Wireb/firepick-delta/electronics/EAT0011/Hardware/README.md

### EAT0011 hot end and extruder module with I2C A2D

This hardware folder contains all the KiCad design files (logical and physical design) for the PCB. 

The gerber subdirectory has the final output files ready to be sent to a board house in standard gerber format. 

Also included in this directory is a PDF of the logics and 2 images of the front and back of the board in PNG format. 

Change list:

1. Updates for new micro.
1. Fixed silk screen for screw terminals.

TODO add info on on card programming.
