Wireb/firepick-delta/electronics/EAT0010/Hardware/EAT0010_board_bot.png

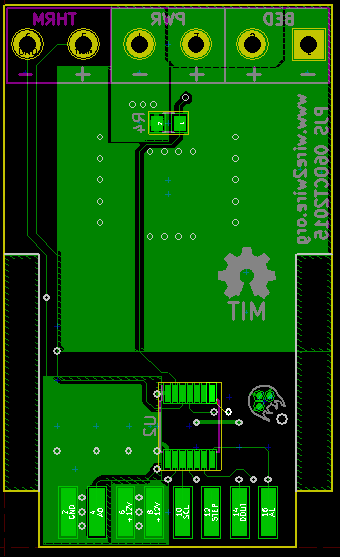
electronics/EAT0010/Hardware/EAT0010_board_bot.png
