Wireb/firepick-delta/electronics/EAT0010/Reworks/EAT0002_to_EAT0010_reworks.png

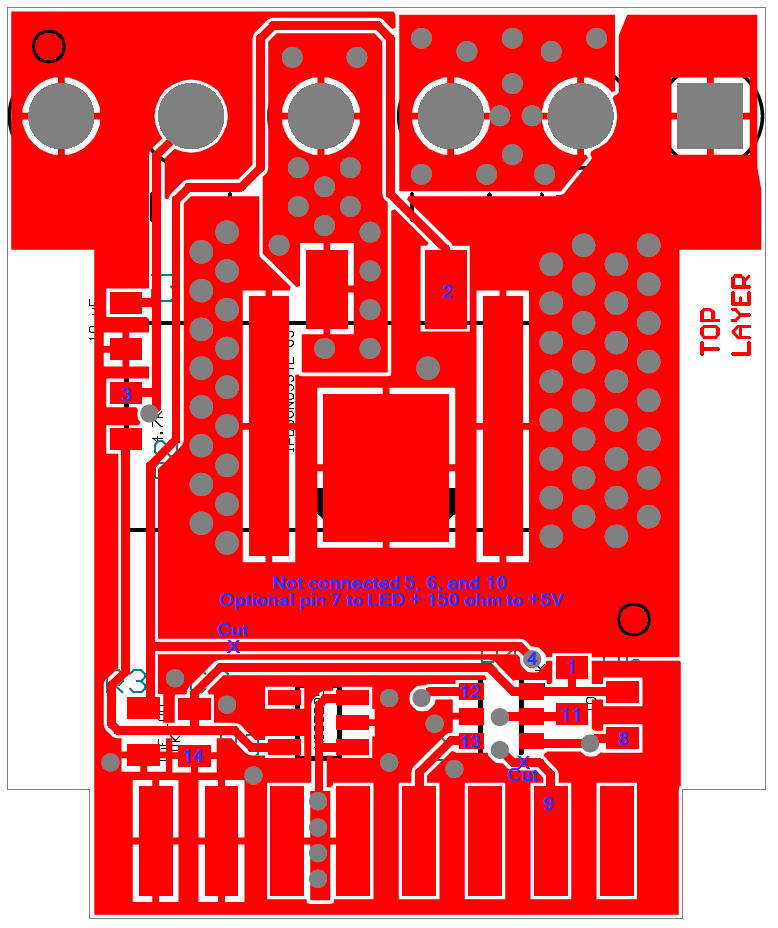
electronics/EAT0010/Reworks/EAT0002_to_EAT0010_reworks.png
