Wireb/firepick-delta/electronics/EAT0011/Hardware/EAT0011_hotend_top.png

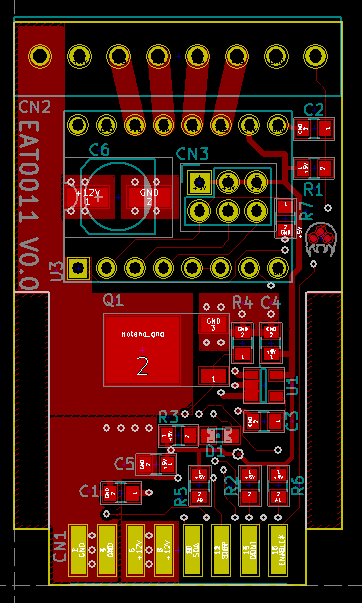
electronics/EAT0011/Hardware/EAT0011_hotend_top.png
