Wireb/firepick-delta/electronics/EAT0011/Reworks/EAT0004_to_EAT0011_top_rework.png

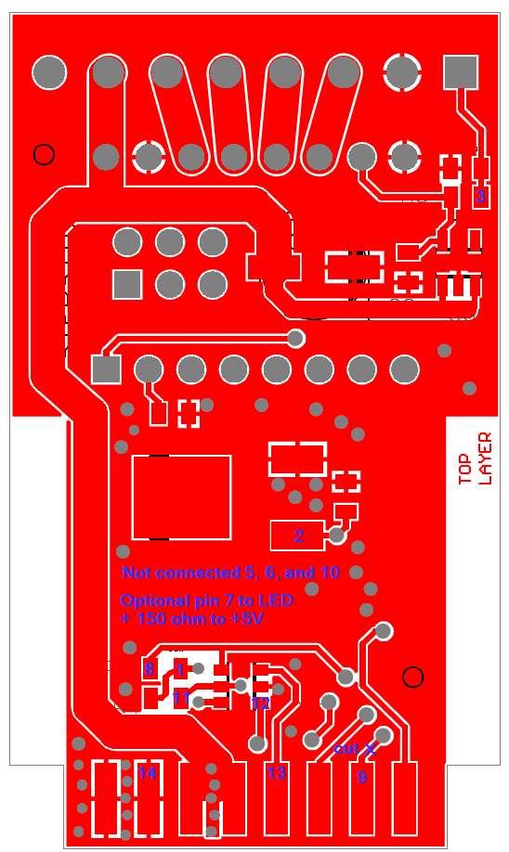
electronics/EAT0011/Reworks/EAT0004_to_EAT0011_top_rework.png
