Wireb/firepick-delta/electronics/EAT0010/Hardware/BOM.xls

 |  |  |  |  | $9.87
Q | part number | footprint | ref_des | price Q 1 | extended | link
1 | 0.1uF | Capacitors_SMD:C_0805 | C5 | $0.10 | $0.10 | http://www.digikey.com/product-detail/en/CL21F104ZBCNNNC/1276-1007-1-ND/3889093
3 | 10k | Capacitors_SMD:C_0805 | R4 R6 R5 | $0.10 | $0.30 | http://www.digikey.com/product-detail/en/RC0805FR-0710KL/311-10.0KCRCT-ND/730482
2 | 10uF | Capacitors_SMD:C_0805 | C2 C1 | $0.20 | $0.40 | http://www.digikey.com/product-detail/en/GRM21BR61E106KA73L/490-5523-1-ND/2334919
1 | 1k | Capacitors_SMD:C_0805 | R3 | $0.10 | $0.10 | http://www.digikey.com/product-detail/en/RC0805FR-071KL/311-1.00KCRCT-ND/730391
1 | 1uF 10V | Capacitors_SMD:C_0805 | C4 | $0.10 | $0.10 | http://www.digikey.com/product-detail/en/CC0805ZRY5V7BB105/311-1457-1-ND/2833763
1 | 4.7k 1% | Capacitors_SMD:C_0805 | R1 | $0.10 | $0.10 | http://www.digikey.com/product-detail/en/RC0805FR-074K7L/311-4.70KCRCT-ND/730876
1 | CONN_02X08 | PJS_smt_std:16pin_straddle_mount_100mil | CN1 | $0.53 | $0.53 | http://www.digikey.com/product-detail/en/PRPC008DAAN-RC/S2011EC-08-ND/2775286
1 | IPD30N03S4L-09 | TO252-3 | Q1 | $0.65 | $0.65 | http://www.digikey.com/product-detail/en/IPD30N03S4L-09/IPD30N03S4L-09INCT-ND/2269936
1 | MIC5205-5.0MB5 | Housings_SOT-23_SOT-143_TSOT-6:SOT-23-5 | U1 | $0.62 | $0.62 | http://www.digikey.com/product-detail/en/MIC5205-5.0YM5%20TR/576-1261-1-ND/771888
1 | OSTTA060161 | On_shore:OSTTA060161 | CN2 | $1.16 | $1.16 | http://www.digikey.com/product-detail/en/OSTTA060161/ED2566-ND/614515
1 | PIC16F1704 | Housings_SSOP:TSSOP-14_4.4x5mm_Pitch0.65mm | U2 | $1.18 | $1.18 | http://www.digikey.com/product-search/en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
1 | Red | LEDs:LED-0805 | D1 | $0.26 | $0.26 | http://www.digikey.com/product-detail/en/LH%20R974-LP-1/475-1415-1-ND/1802604
1 | V-1100-SMD/B | PJS_smt_std:V-1100-SMD | HS1 | $0.70 | $0.70 | http://www.digikey.com/product-detail/en/V-1100-SMD%2FB-L/AE10775-ND/3511509
1 | PCB |  |  | $3.67 | $3.67 | https://www.oshpark.com/shared_projects/yRDqqqbZ
