Wireb/firepick-delta/electronics/EAT0011/Hardware/BOM.xls

 |  |  |  |  | $15.16
Q | part number | footprint | ref_des | price Q 1 | extended | link
1 | 0.1uF | Capacitors_SMD:C_0805 | C5 | $0.10 | $0.10 | http://www.digikey.com/product-detail/en/CL21F104ZBCNNNC/1276-1007-1-ND/3889093
1 | 100k | Capacitors_SMD:C_0805 | R7 | $0.10 | $0.00 | http://www.digikey.com/product-detail/en/RC0805FR-07100KL/311-100KCRCT-ND/730491
1 | 100uF 25V | Capacitors_SMD:c_elec_6.3x7.7 | C6 | $0.37 | $0.00 | http://www.digikey.com/product-detail/en/UWT1E101MCL1GS/493-2190-1-ND/590165
3 | 10k | Capacitors_SMD:C_0805 | R4 R6 R5 | $0.10 | $0.30 | http://www.digikey.com/product-detail/en/RC0805FR-0710KL/311-10.0KCRCT-ND/730482
2 | 10uF | Capacitors_SMD:C_0805 | C2 C1 | $0.20 | $0.40 | http://www.digikey.com/product-detail/en/GRM21BR61E106KA73L/490-5523-1-ND/2334919
1 | 1k | Capacitors_SMD:C_0805 | R3 | $0.10 | $0.10 | http://www.digikey.com/product-detail/en/RC0805FR-071KL/311-1.00KCRCT-ND/730391
1 | 1uF 10V | Capacitors_SMD:C_0805 | C4 | $0.10 | $0.10 | http://www.digikey.com/product-detail/en/CC0805ZRY5V7BB105/311-1457-1-ND/2833763
1 | 4.7k 1% | Capacitors_SMD:C_0805 | R1 | $0.10 | $0.10 | http://www.digikey.com/product-detail/en/RC0805FR-074K7L/311-4.70KCRCT-ND/730876
1 | CONN_02X03 | Socket_Strips:Socket_Strip_Straight_2x03 | CN3 | $0.31 | $0.00 | http://www.digikey.com/product-detail/en/67997-206HLF/609-3234-ND/1878491
1 | CONN_02X08 | PJS_smt_std:16pin_straddle_mount_100mil | CN1 | $0.53 | $0.53 | http://www.digikey.com/product-detail/en/PRPC008DAAN-RC/S2011EC-08-ND/2775286
1 | FQD13N06LTM | PJS_smt_std:D-Pak_TO252AA | Q1 | $0.68 | $0.00 | http://www.digikey.com/product-search/en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
1 | JST OSTTE080104 | On_shore:OSTTE080104 | CN2 | $1.21 | $0.00 | http://www.digikey.com/product-search/en?vendor=0&keywords=OSTTE080104
1 | MIC5205-5.0MB5 | Housings_SOT-23_SOT-143_TSOT-6:SOT-23-5 | U1 | $0.62 | $0.62 | http://www.digikey.com/product-detail/en/MIC5205-5.0YM5%20TR/576-1261-1-ND/771888
1 | PIC16F1704 | Housings_SSOP:TSSOP-14_4.4x5mm_Pitch0.65mm | U2 | $1.18 | $1.18 | http://www.digikey.com/product-search/en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
1 | Red | LEDs:LED-0805 | D1 | $0.26 | $0.26 | http://www.digikey.com/product-detail/en/LH%20R974-LP-1/475-1415-1-ND/1802604
1 | Stepstick | Stepstick:Stepstick | U3 | $5.95 | $5.95 | https://www.pololu.com/product/1182
2 | sockets for above | pth 1x8 0.1" pitch |  | $0.86 | $1.72 | http://www.digikey.com/product-detail/en/PPTC081LFBN-RC/S7006-ND/810147
1 | PCB |  |  | $3.80 | $3.80 | https://www.oshpark.com/shared_projects/VwKjZDkB
