Wireb/firepick-delta/electronics/EAT0010/Hardware/partnumber.csv

Q | part number | footprint | ref_des
1 | 0.1uF | Capacitors_SMD:C_0805 | C5
3 | 10k | Capacitors_SMD:C_0805 | R4 R6 R5
2 | 10uF | Capacitors_SMD:C_0805 | C2 C1
1 | 1k | Capacitors_SMD:C_0805 | R3
1 | 1uF 10V | Capacitors_SMD:C_0805 | C4
1 | 4.7k 1% | Capacitors_SMD:C_0805 | R1
1 | CONN_02X08 | PJS_smt_std:16pin_straddle_mount_100mil | CN1
1 | IPD30N03S4L-09 | TO252-3 | Q1
1 | MIC5205-5.0MB5 | Housings_SOT-23_SOT-143_TSOT-6:SOT-23-5 | U1
1 | Metroid | PJS-icons:metroid | icon1
1 | OSTTA060161 | On_shore:OSTTA060161 | CN2
1 | PIC16F1704 | Housings_SSOP:TSSOP-14_4.4x5mm_Pitch0.65mm | U2
1 | Red | LEDs:LED-0805 | D1
1 | V-1100-SMD/B | PJS_smt_std:V-1100-SMD | HS1
0 | no_pop | Capacitors_SMD:C_0805 | C3 R2
