Wireb/firepick-delta/electronics/EAT0011/Hardware/FPD_bed_EAT0011.pdf

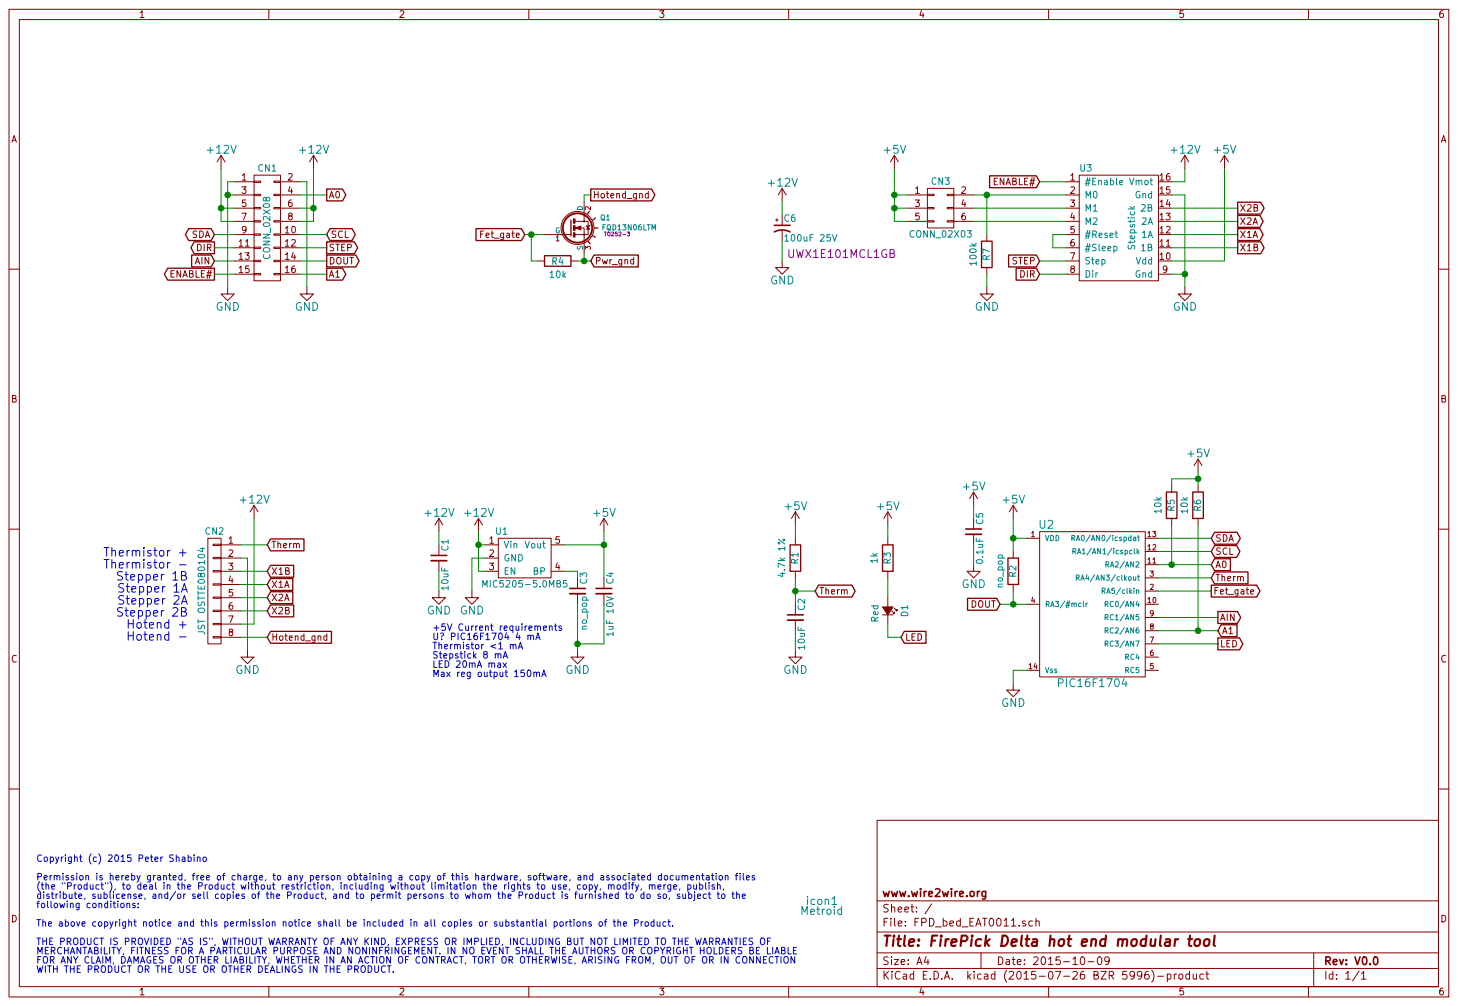
[picture p8: page 1]

2 | X1B Thermistor +

+5V Current requirements U? PIC16F1704 4 mA
Thermistor <1 mA
Stepstick 8 mA
LED 20mA max Max reg output 150mA

Copyright (c) 2015 Peter Shabino
Permission is hereby granted, free of charge, to any person obtaining a copy of this hardware, software, and associated documentation files
(the "Product"), to deal in the Product without restriction, including without limitation the rights to use, copy, modify, merge, publish,
distribute, sublicense, and/or sell copies of the Product, and to permit persons to whom the Product is furnished to do so, subject to the
following conditions:
The above copyright notice and this permission notice shall be included in all copies or substantial portions of the Product. THE PRODUCT IS PROVIDED "AS IS", WITHOUT WARRANTY OF ANY KIND, EXPRESS OR IMPLIED, INCLUDING BUT NOT LIMITED TO THE WARRANTIES OF MERCHANTABILITY, FITNESS FOR A PARTICULAR PURPOSE AND NONINFRINGEMENT. IN NO EVENT SHALL THE AUTHORS OR COPYRIGHT HOLDERS BE LIABLE FOR ANY CLAIM, DAMAGES OR OTHER LIABILITY, WHETHER IN AN ACTION OF CONTRACT, TORT OR OTHERWISE, ARISING FROM, OUT OF OR IN CONNECTION WITH THE PRODUCT OR THE USE OR OTHER DEALINGS IN THE PRODUCT.

File: FPD_bed_EAT0011.sch Sheet: / www.wire2wire.org

Id: 1/1 Title: FirePick Delta hot end modular tool
