Wireb/firepick-delta/electronics/EAT0011/Hardware/FPD_bed_EAT0011.kicad_pcb

## KiCad design electronics/EAT0011/Hardware/FPD_bed_EAT0011.kicad_pcb (2015-10-26)

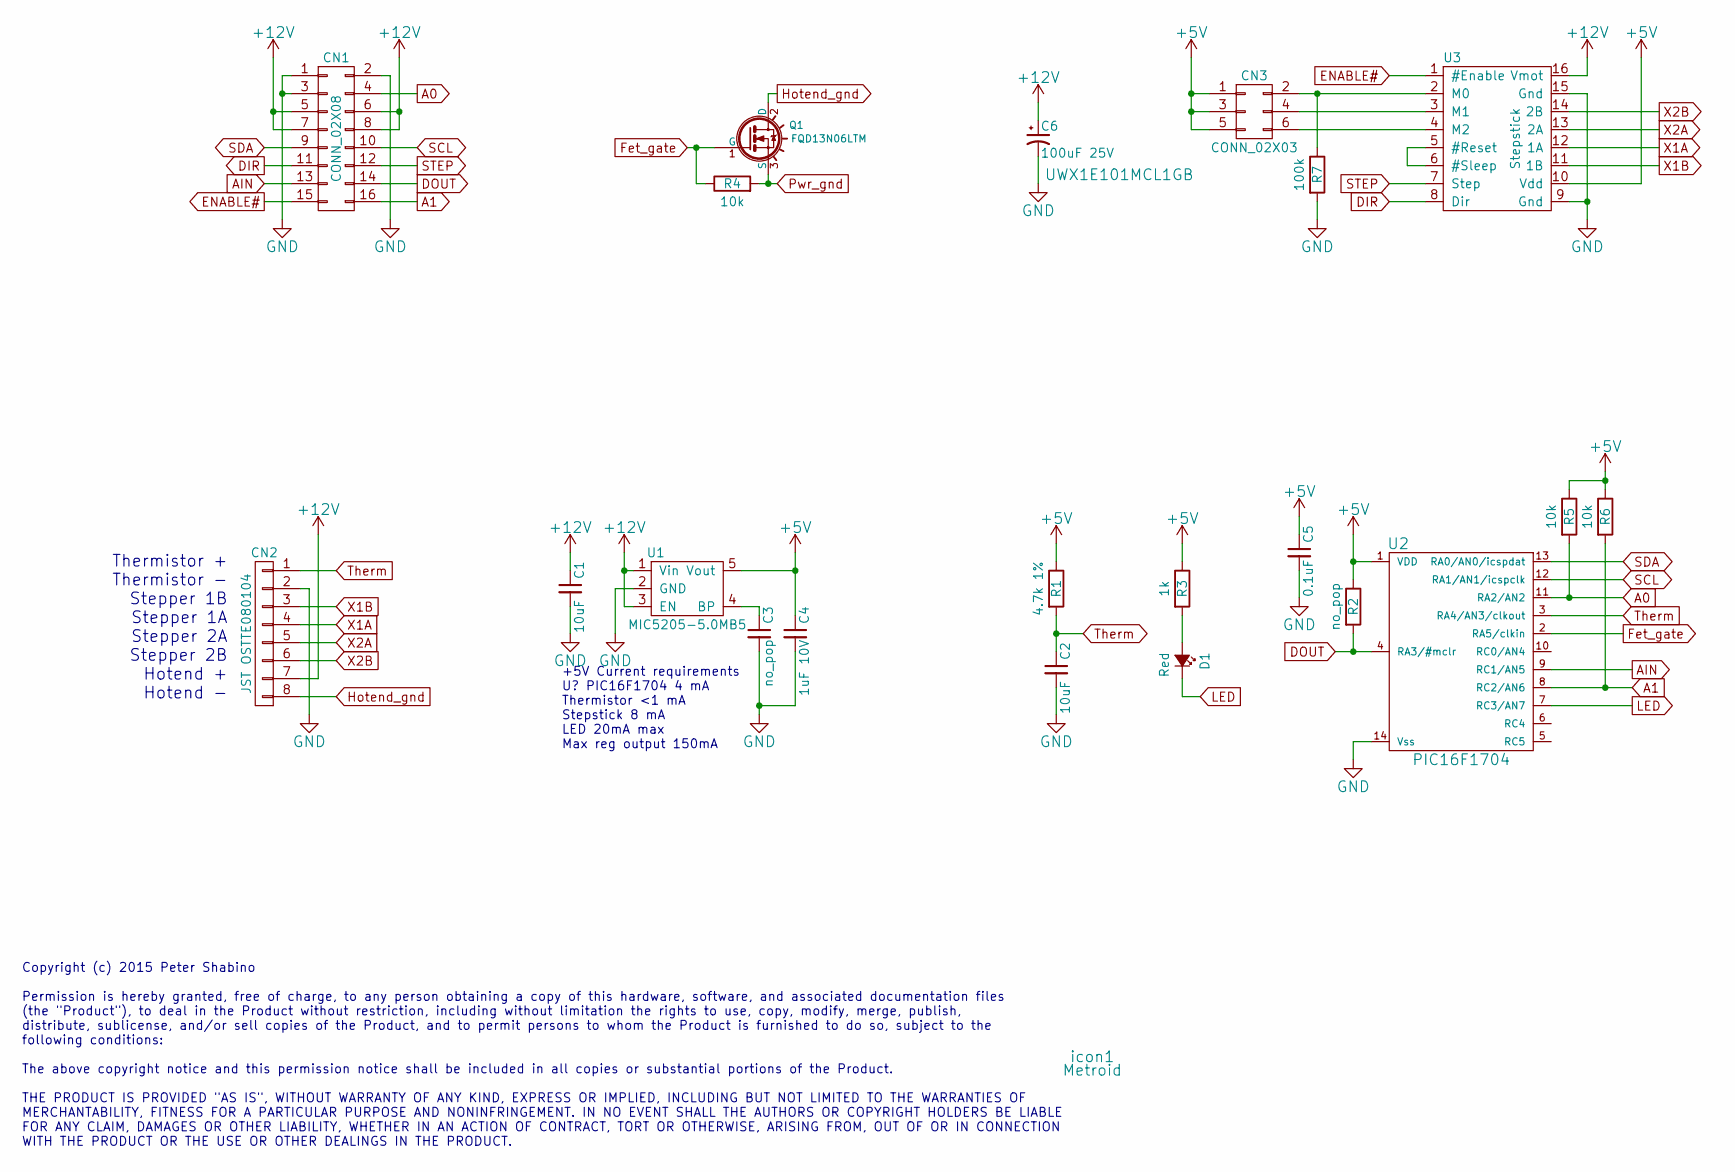
[picture p9: schematic FPD_bed_EAT0011.sch, FirePick Delta hot end modular tool]

Parts:
C1, C2: 10uF; C_0805
C3: no_pop; C_0805
C4: 1uF 10V; C_0805
C5: 0.1uF; C_0805
C6: 100uF 25V; c_elec_6.3x7.7
CN1: CONN_02X08; 16pin_straddle_mount_100mil
CN2: JST OSTTE080104; OSTTE080104
CN3: CONN_02X03; Socket_Strip_Straight_2x03
D1: Red; LED-0805
Q1: FQD13N06LTM; D-Pak_TO252AA
R1: 4.7k 1%; C_0805
R2: no_pop; C_0805
R3: 1k; C_0805
R4, R5, R6: 10k; C_0805
R7: 100k; C_0805
U1: MIC5205-5.0MB5; SOT-23-5
U2: PIC16F1704; TSSOP-14_4.4x5mm_Pitch0.65mm
U3: Stepstick
icon1: Metroid; metroid

Connections:
+5V: C4.1, C5.1, CN3.1, CN3.3, CN3.5, R1.1, R2.1, R3.1, R5.1, R6.1, U1.5 (Vout), U2.1 (VDD), U3.10 (Vdd)
+12V: C1.1, C6.1, CN1.5, CN1.6, CN1.7, CN1.8, CN2.7, U1.1 (Vin), U1.3 (EN), U3.16 (Vmot)
A0: CN1.4, R5.2, U2.11 (RA2/AN2)
A1: CN1.16, R6.2, U2.8 (RC2/AN6)
AIN: CN1.13, U2.9 (RC1/AN5)
DIR: CN1.11, U3.8 (Dir)
DOUT: CN1.14, R2.2, U2.4 (RA3/#mclr)
ENABLE#: CN1.15, U3.1 (#Enable)
Fet_gate: Q1.1 (G), R4.1, U2.2 (RA5/clkin)
GND: C1.2, C2.2, C3.2, C4.2, C5.2, C6.2, CN1.1, CN1.2, CN1.3, CN2.2, R7.2, U1.2 (GND), U2.14 (Vss), U3.9 (Gnd), U3.15 (Gnd)
Hotend_gnd: CN2.8, Q1.2 (D)
LED: D1.2 (C), U2.7 (RC3/AN7)
unnamed: C3.1, U1.4 (BP)
unnamed: CN3.2, R7.1, U3.2 (M0)
unnamed: CN3.4, U3.3 (M1)
unnamed: CN3.6, U3.4 (M2)
unnamed: D1.1 (A), R3.2
unnamed: U3.5 (#Reset), U3.6 (#Sleep)
Pwr_gnd: Q1.3 (S), R4.2
SCL: CN1.10, U2.12 (RA1/AN1/icspclk)
SDA: CN1.9, U2.13 (RA0/AN0/icspdat)
STEP: CN1.12, U3.7 (Step)
Therm: C2.1, CN2.1, R1.2, U2.3 (RA4/AN3/clkout)
X1A: CN2.4, U3.12 (1A)
X1B: CN2.3, U3.11 (1B)
X2A: CN2.5, U3.13 (2A)
X2B: CN2.6, U3.14 (2B)

Notes on the sheet:
Copyright (c) 2015 Peter Shabino Permission is hereby granted, free of charge, to any person obtaining a copy of this hardware, software, and associated documentation files (the "Product"), to deal in the Product without restriction, including without limitation the rights to use, copy, modify, mer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
+5V Current requirements U? PIC16F1704 4 mA Thermistor <1 mA Stepstick 8 mA LED 20mA max Max reg output 150mA
Thermistor + Thermistor - Stepper 1B Stepper 1A Stepper 2A Stepper 2B Hotend + Hotend -

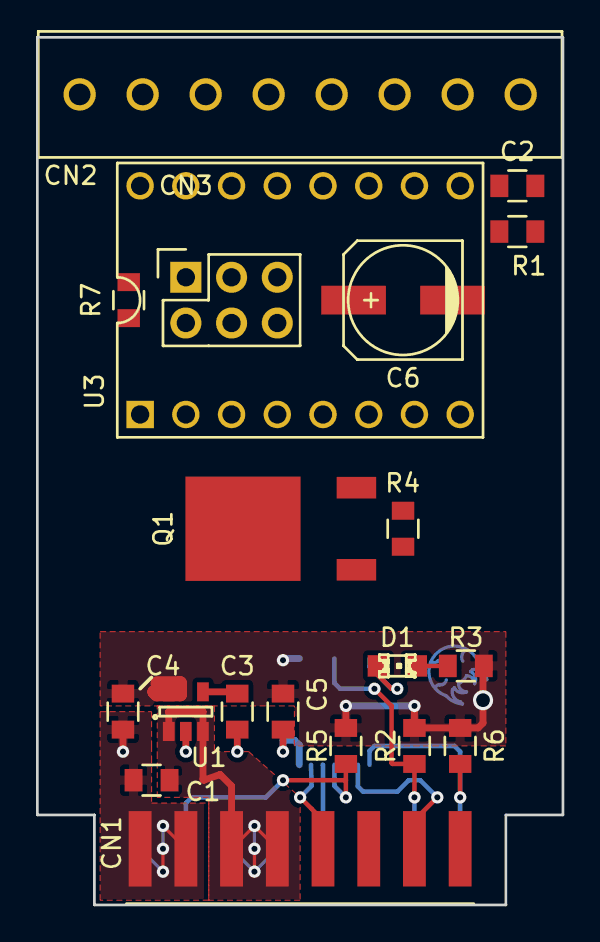
[picture p10: board FPD_bed_EAT0011.kicad_pcb from above]

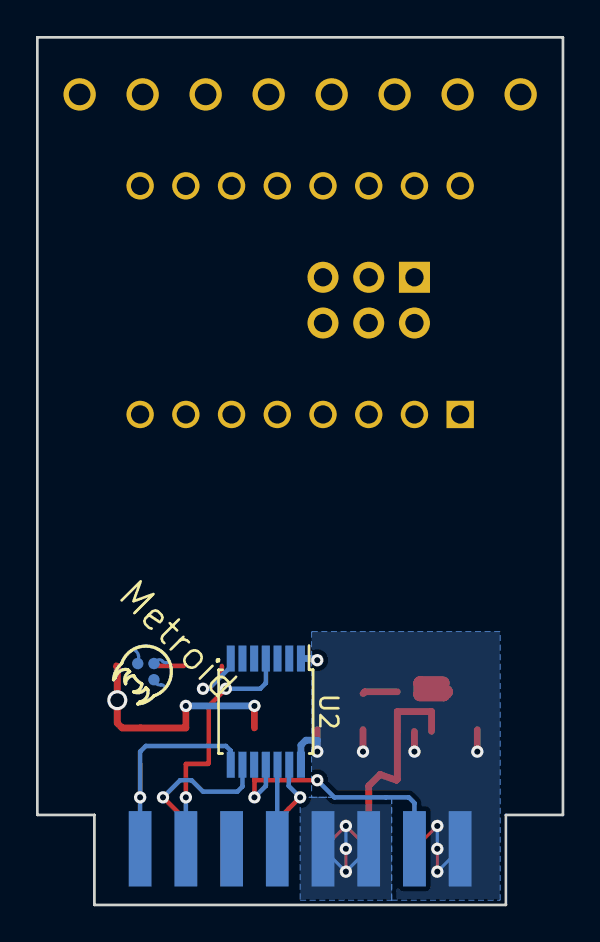
[picture p11: board FPD_bed_EAT0011.kicad_pcb from below]

Board: 2 copper layers, 29.2 x 48.2 mm, 23 parts (3 on the bottom side), 27 nets.

Other parts of the board:
ICON***: OSH; OSH4mm
