Wireb/firepick-delta/(commit log)

2015-10-07 First pass of the EAT0010 board added
    [FPD_bed_EAT0010.GBL, FPD_bed_EAT0010.GBO, FPD_bed_EAT0010.GBS, FPD_bed_EAT0010.GKO, FPD_bed_EAT0010.GTL, FPD_bed_EAT0010.GTO, FPD_bed_EAT0010.GTS, FPD_bed_EAT0010.XLN]
2015-10-08 Added tool slot to I2C address table
2015-10-08 PCB updates
    Added thermals and slid parts around a bit for better spacing
    [FPD_bed_EAT0010.GBL, FPD_bed_EAT0010.GBO, FPD_bed_EAT0010.GBS, FPD_bed_EAT0010.GKO, FPD_bed_EAT0010.GTL, FPD_bed_EAT0010.GTO, FPD_bed_EAT0010.GTS, FPD_bed_EAT0010.XLN]
2015-10-11 Added BOM
    Added BOM and links to parts / PCBs
    [BOM.xls, partnumber.csv, refdes.csv]
2015-10-17 EAT0011 started
    Logics done started PCB
    [FPD_bed_EAT0011.kicad_pcb, FPD_bed_EAT0011.sch, partnumber.csv]
2015-10-26 Fixed solder mask added EAT0011 files
    solder mask for the straddle mount header was both on the top layer
    instead of both layers. Finished the EAT0011 module data and BOM.
    [BOM.xls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]
